christrotter/top-encoder-pcb/top-encoder-pcb-v2.step

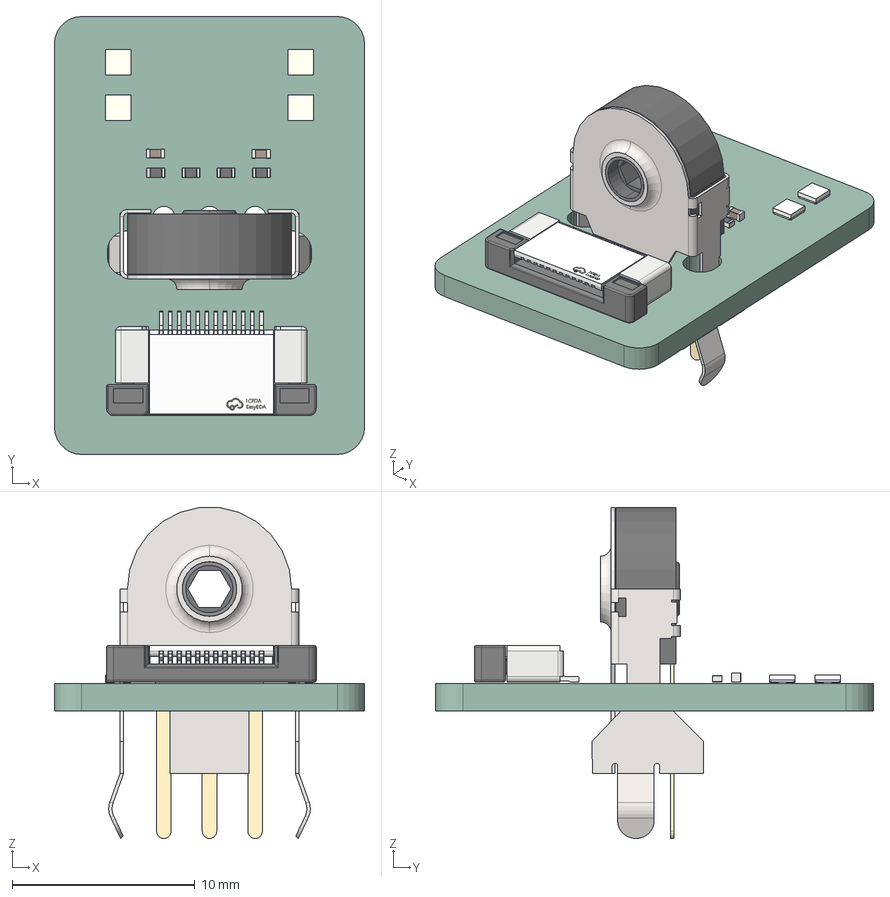
[picture p7: CAD file, 2026-04-19]
top-encoder-pcb-v2.step
17.0 x 24.0 x 18.1 mm
LED-SMD_4P-L1.4-W1.4-TL x 4
FFC-SMD_FFC05001-12SBA124W5M
C_0402_1005Metric x 2
R_0402_1005Metric x 4
SW-TH_EC10EXXXXXXX
top-encoder-pcb_PCB
