christrotter/top-encoder-pcb/top-encoder-pcb.kicad_pcb

## KiCad design top-encoder-pcb.kicad_pcb (2026-04-19)

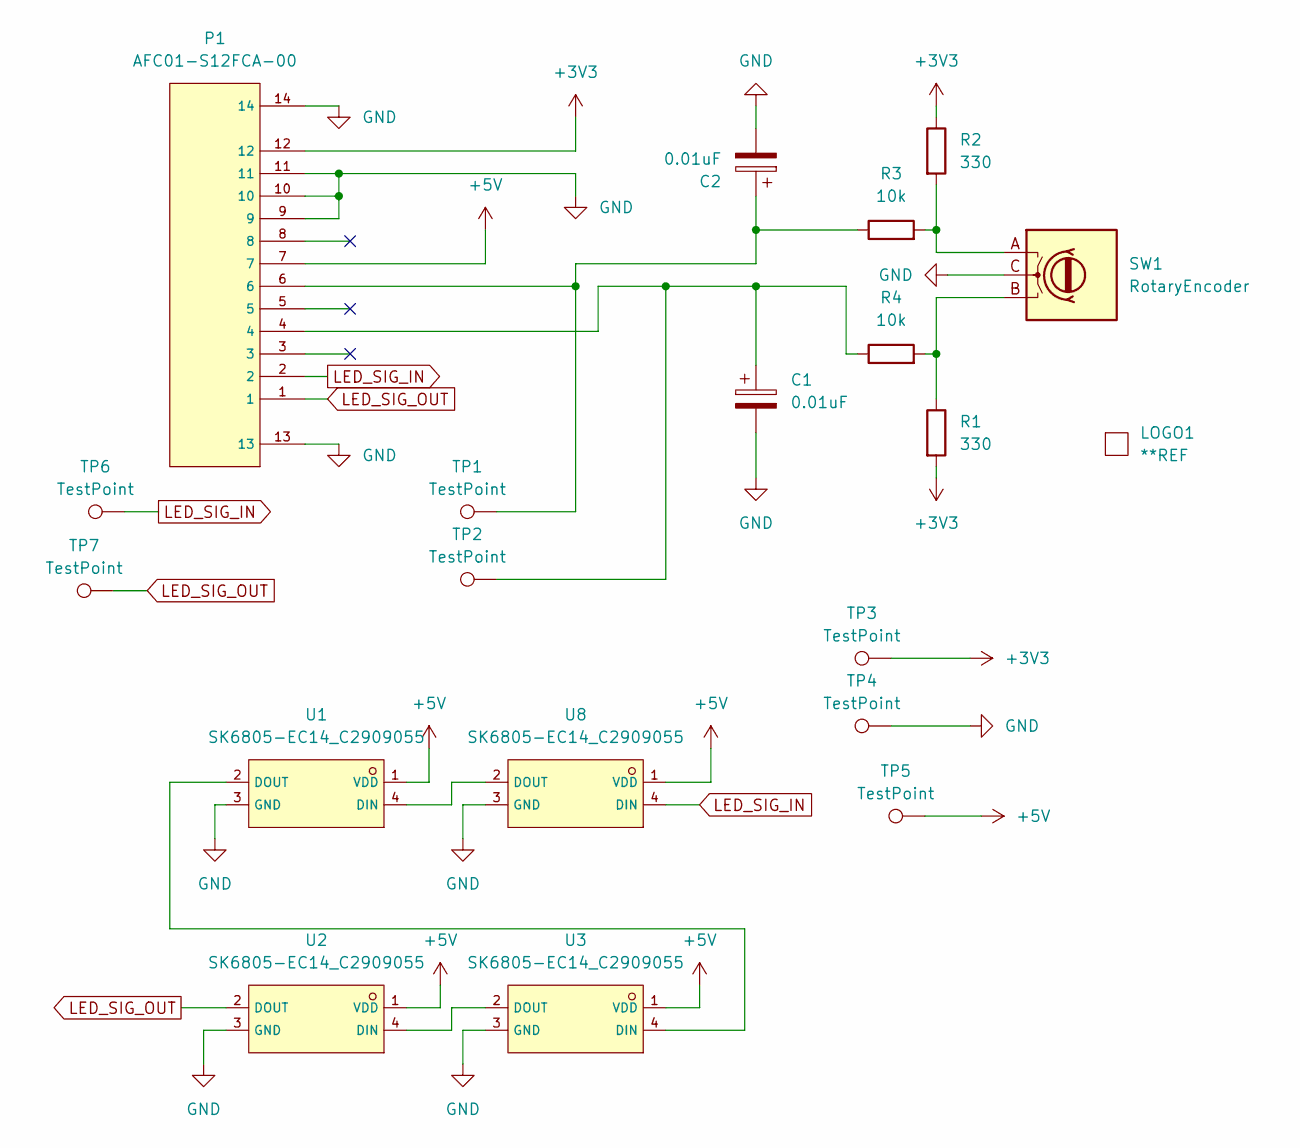
[picture p8: schematic top-encoder-pcb.kicad_sch]

Parts:
C1, C2: 0.01uF; C_0402_1005Metric
LOGO1: **REF; awesome-logo
P1: AFC01-S12FCA-00; FPC-SMD_AFC01-S12FCA-00; LCSC C262661
R1, R2: 330; R_0402_1005Metric
R3, R4: 10k; R_0402_1005Metric
SW1: RotaryEncoder; SW-TH_EC10EXXXXXXX
TP1, TP2, TP3, TP4, TP5, TP6, TP7: TestPoint; TestPoint_Pad_D1.0mm
U1, U2, U3, U8: SK6805-EC14_C2909055; LED-SMD_4P-L1.4-W1.4-TL; LCSC C2909055

Connections:
+3V3: P1.12, R1.2, R2.1, TP3.1
+5V: P1.7, TP5.1, U1.1 (VDD), U2.1 (VDD), U3.1 (VDD), U8.1 (VDD)
GND: C1.2, C2.2, P1.9, P1.10, P1.11, P1.13, P1.14, SW1.C, TP4.1, U1.3 (GND), U2.3 (GND), U3.3 (GND), U8.3 (GND)
LED_SIG_IN: P1.2, TP6.1, U8.4 (DIN)
LED_SIG_OUT: P1.1, TP7.1, U2.2 (DOUT)
unnamed: C1.1, P1.4, R4.1, TP2.1
unnamed: C2.1, P1.6, R3.1, TP1.1
unnamed: R1.1, R4.2, SW1.B
unnamed: R2.2, R3.2, SW1.A
unnamed: U1.4 (DIN), U8.2 (DOUT)
unnamed: U1.2 (DOUT), U3.4 (DIN)
unnamed: U2.4 (DIN), U3.2 (DOUT)

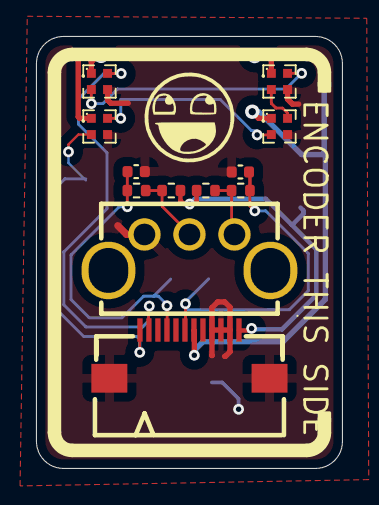
[picture p9: board top-encoder-pcb.kicad_pcb from above]

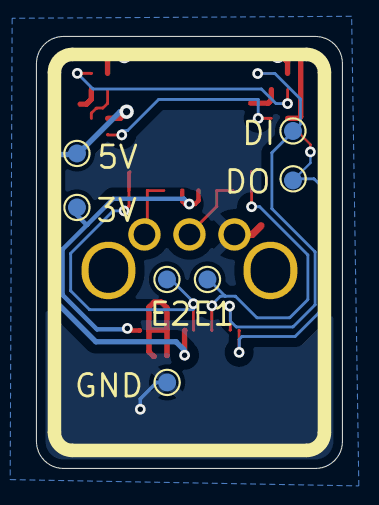
[picture p10: board top-encoder-pcb.kicad_pcb from below]

Board: 2 copper layers, 17.0 x 24.0 mm, 20 parts (7 on the bottom side), 12 nets.
